lfkeyboards/lfk17/README.md

# LFK17

Open source 17-key numpad.

License: [CC BY-NC-SA 4.0](https://creativecommons.org/licenses/by-nc-sa/4.0/)
