lfkeyboards/lfk17/RevB/gerbers/lfk17-drl_map.dxf

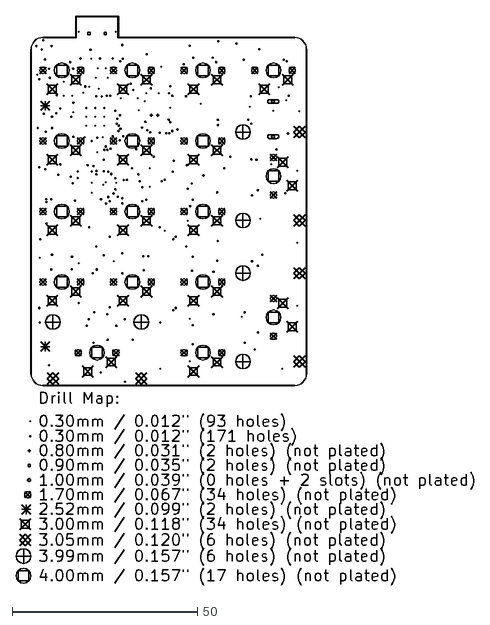
[picture p1: CAD file, 2018-01-06]
RevB/gerbers/lfk17-drl_map.dxf
123.6 x 153.6
