lfkeyboards/lfk17/RevB/lfk17.kicad_pcb

## KiCad design RevB/lfk17.kicad_pcb (2018-01-16)

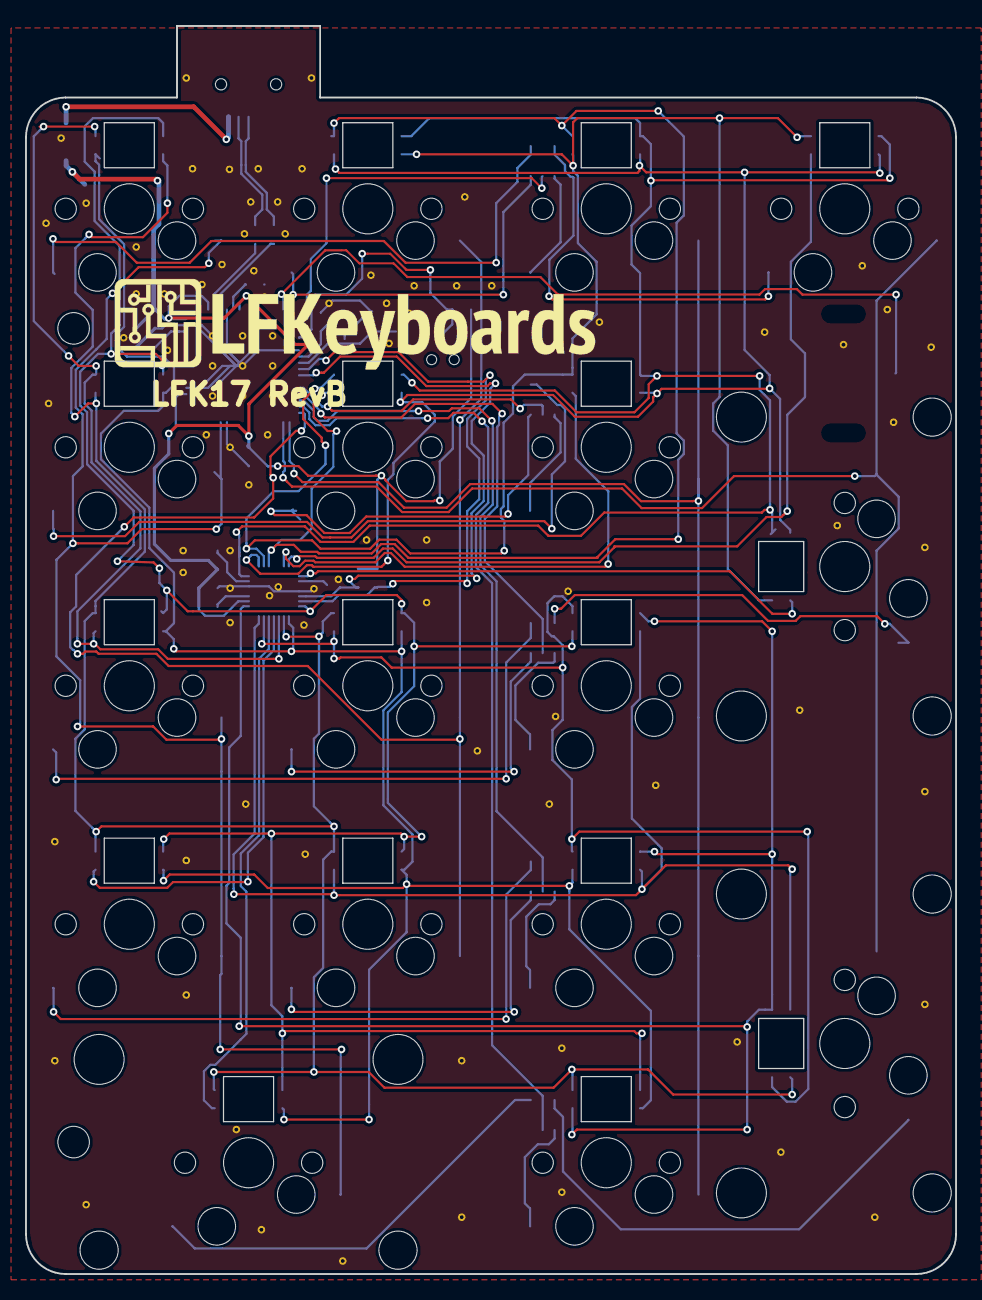
[picture p2: board lfk17.kicad_pcb from above]

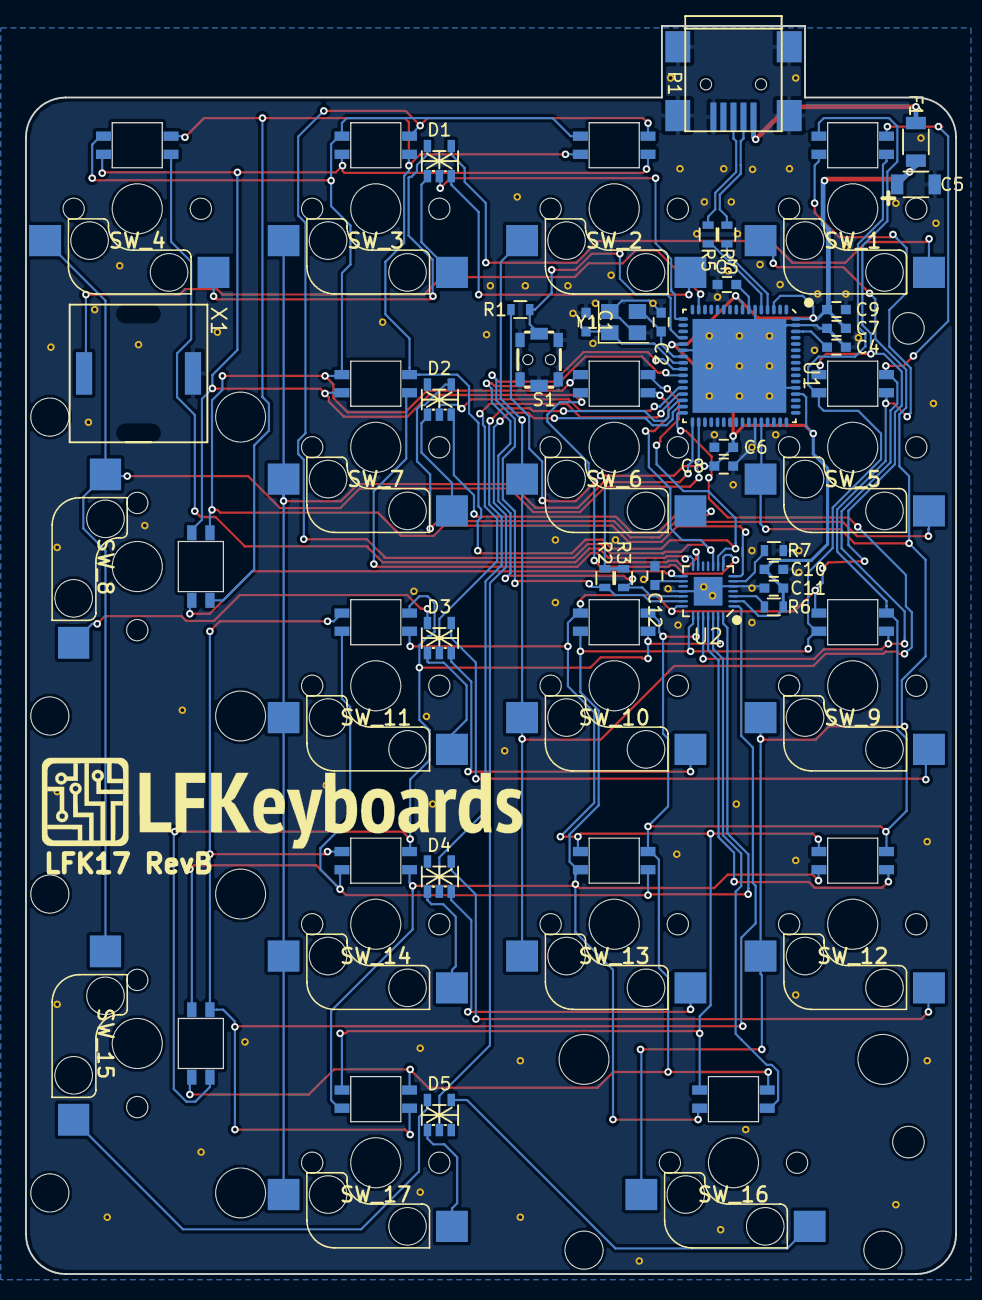
[picture p3: board lfk17.kicad_pcb from below]

Board: 2 copper layers, 74.3 x 99.7 mm, 53 parts (27 on the bottom side), 60 nets.

Parts:
C1, C2: 18pF; C_0603
C3, C6, C7, C8, C9, C11, C12: 0.1µF; C_0603
C4, C10: 1µF; C_0603
C5: 4.7µF; C_1206
D1, D2, D3, D4, D5: 1SS309; SC-74A
F1: FP_Small; C_1206
Logo: Logo; LFKeyboards_logo_8mm
Logo#2: Logo; LFKeyboards_logo_8mm
P1: USB_OTG; USB_Mini-B
R1, R6: 10k; R_0603
R2, R3: 4.7k; R_0603
R4, R5: 22; R_0603
R7: 30k; R_0603
S1: SW_PUSH; PTS-820_SPST
STA: Stabilizer; CHERRY_PCB_200_STABILIZER
STA#2, STA#3: Stabilizer; CHERRY_PCB_200_STABILIZER
SW_1, SW_2, SW_3, SW_4, SW_5, SW_6, SW_7, SW_8, SW_9, SW_10, SW_11, SW_12, SW_13, SW_14, SW_15, SW_16, SW_17: MX_LED; MXHS-1U-RGB-ALI-3528-HOLE-NOPAD
U1: AT90USB1286-AU; QFN_64
U2: IS31FL3731; QFN_28
X1: Piezo; piezo-9x9
Y1: CRYSTAL_32x25; Crystal_SMD_3225-4pin_3.2x2.5mm

Connections:
+5v: C5.1, C6.1, C7.1, C8.1, C9.1, C10.1, C11.1, F1.2, R1.1, R2.1, R3.1, R6.1, U1.3, U1.8, U1.21, U1.52, U1.64, U2.2
AUDIO: U1.15, X1.1
Col1: SW_1.MX1, SW_5.MX1, SW_9.MX1, SW_12.MX1, SW_16.MX1, U1.44
Col2: SW_2.MX1, SW_6.MX1, SW_10.MX1, SW_13.MX1, U1.32
Col3: SW_3.MX1, SW_7.MX1, SW_11.MX1, SW_14.MX1, SW_17.MX1, U1.33
Col4: SW_4.MX1, SW_8.MX1, SW_15.MX1, U1.34
D+: R5.1, U1.5
D-: R4.1, U1.4
GND: C1.1, C2.1, C3.2, C4.2, C5.2, C6.2, C7.2, C8.2, C9.2, C10.2, C11.2, C12.1, P1.5, P1.6, R7.1, S1.2, S1.3, U1.6, U1.22, U1.43, U1.53, U1.63, U1.65, U2.5, U2.18, X1.2, Y1.2, Y1.4
L0_1: SW_1.R, SW_5.R, SW_9.R, SW_10.R, SW_11.A, SW_12.R, SW_13.R, SW_16.R, SW_17.R, U2.21
L0_2: SW_1.A, SW_5.G, SW_9.G, SW_10.G, SW_12.G, SW_13.G, SW_14.A, SW_16.G, SW_17.G, U2.22
L0_3: SW_1.G, SW_5.A, SW_9.B, SW_10.B, SW_12.B, SW_13.B, SW_15.A, SW_16.B, SW_17.B, U2.23
L0_4: SW_1.B, SW_5.B, SW_9.A, U2.24
L0_5: SW_12.A, U2.25
L0_6: SW_16.A, U2.26
L0_7: SW_10.A, SW_11.B, SW_14.B, SW_15.B, U2.27
L0_8: SW_11.G, SW_13.A, SW_14.G, SW_15.G, U2.28
L0_9: SW_11.R, SW_14.R, SW_15.R, SW_17.A, U2.1
L1_1: SW_2.R, SW_3.R, SW_4.R, SW_6.R, SW_7.R, SW_8.R, U2.7
L1_2: SW_2.A, SW_3.G, SW_4.G, SW_6.G, SW_7.G, SW_8.G, U2.8
L1_3: SW_2.G, SW_3.A, SW_4.B, SW_6.B, SW_7.B, SW_8.B, U2.9
L1_4: SW_2.B, SW_3.B, SW_6.A, U2.10
L1_7: SW_7.A, U2.13
L1_8: SW_4.A, U2.14
L1_9: SW_8.A, U2.15
LED_SCL: R2.2, U1.25, U2.20
LED_SDA: R3.2, U1.26, U2.19
Matrix-SW_1-D1-4: D1.4, SW_1.MX2
Matrix-SW_2-D1-3: D1.3, SW_2.MX2
Matrix-SW_3-D1-1: D1.1, SW_3.MX2
Matrix-SW_4-D1-5: D1.5, SW_4.MX2
Matrix-SW_5-D2-4: D2.4, SW_5.MX2
Matrix-SW_6-D2-3: D2.3, SW_6.MX2
Matrix-SW_7-D2-1: D2.1, SW_7.MX2
Matrix-SW_8-D3-5: D3.5, SW_8.MX2
Matrix-SW_9-D3-4: D3.4, SW_9.MX2
Matrix-SW_10-D3-3: D3.3, SW_10.MX2
Matrix-SW_11-D3-1: D3.1, SW_11.MX2
Matrix-SW_12-D4-4: D4.4, SW_12.MX2
Matrix-SW_13-D4-3: D4.3, SW_13.MX2
Matrix-SW_14-D4-1: D4.1, SW_14.MX2
Matrix-SW_15-D5-5: D5.5, SW_15.MX2
Matrix-SW_16-D5-4: D5.4, SW_16.MX2
Matrix-SW_17-D5-1: D5.1, SW_17.MX2
unnamed: C1.2, U1.24, Y1.1
unnamed: C2.2, U1.23, Y1.3
unnamed: C3.1, U1.7
unnamed: C4.1, U1.62
unnamed: R6.2, U2.3
unnamed: R7.2, U2.6
unnamed: C12.2, U2.16
RESET: R1.2, S1.1, U1.20
Row1: D1.2, U1.17
Row2: D2.2, U1.28
Row3: D3.2, U1.29
Row4: D4.2, U1.30
Row5: D5.2, U1.31
USB+: P1.3, R5.2
USB-: P1.2, R4.2
VBUS: F1.1, P1.1
