lfkeyboards/lfk17/(commit log)

2018-01-06 Add kicad project
    [lfk17-B.Cu.gbl, lfk17-B.Mask.gbs, lfk17-B.Paste.gbp, lfk17-B.SilkS.gbo, lfk17-Edge.Cuts.gm1, lfk17-F.Cu.gtl, lfk17-F.Mask.gts, lfk17-F.SilkS.gto]
2018-01-06 Added drill map as dxf
    [lfk17-drl_map.dxf]
2018-01-16 Added hotswap footprint
    [lfk17.kicad_pcb]
